easytarget/Aqua328-Hardware/Docs/AT328-aqua-controller.jpg

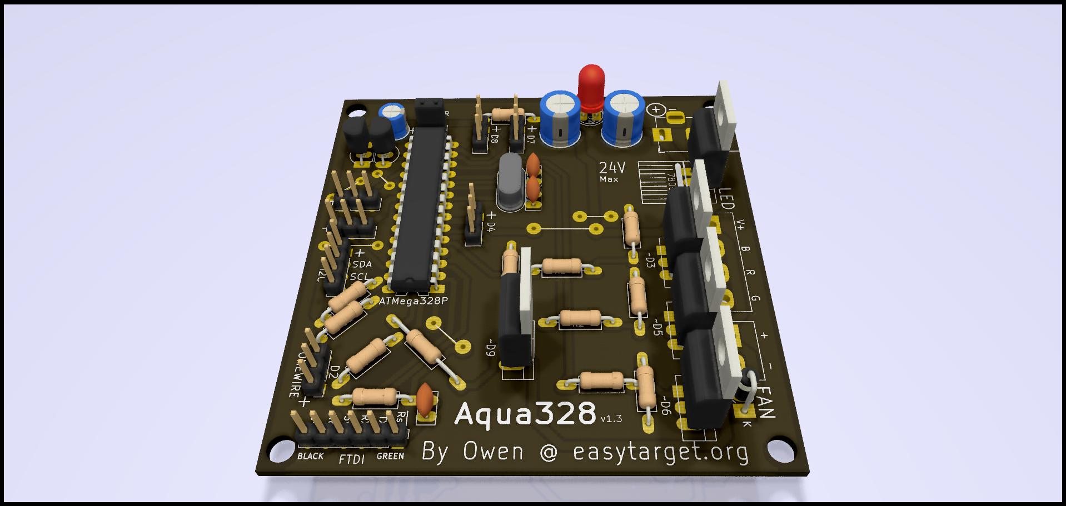
Docs/AT328-aqua-controller.jpg
