easytarget/Aqua328-Hardware/README.md

# Controller for a Public (attended) aquarium

See the Full project log on:
https://hackaday.io/project/167871-aqua328-flexible-aquarium-controller

Software is in:
https://github.com/easytarget/Aqua328-Software
