easytarget/Aqua328-Hardware/Case/aqua328-case.png

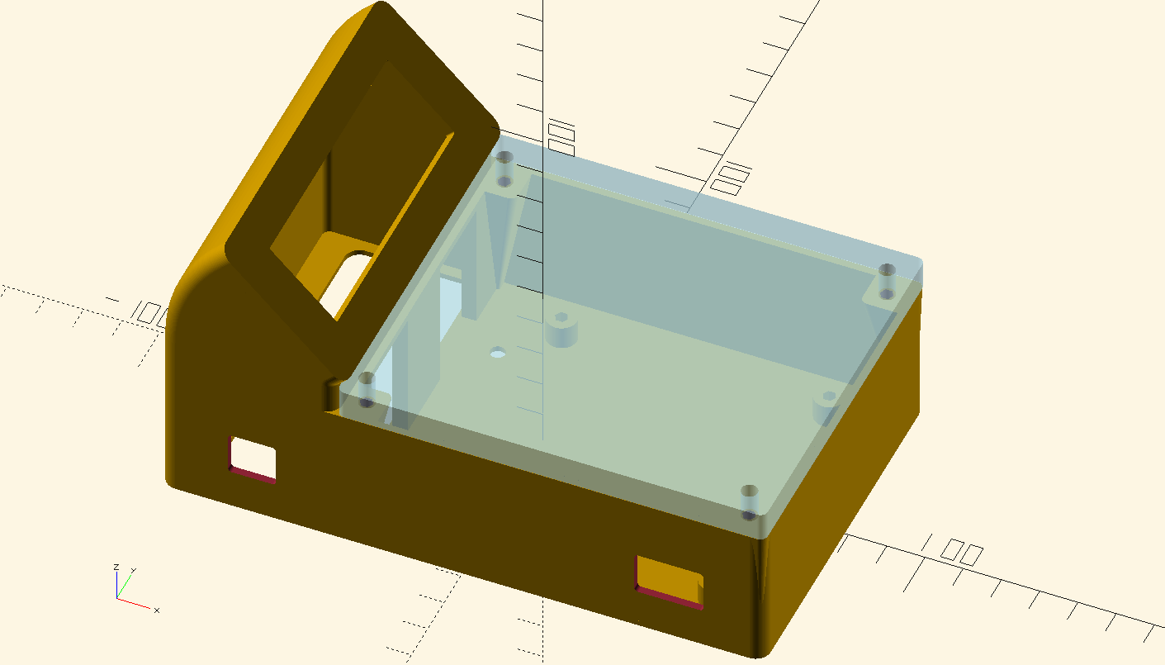
Case/aqua328-case.png
