easytarget/Aqua328-Hardware/Docs/Schematic.jpg

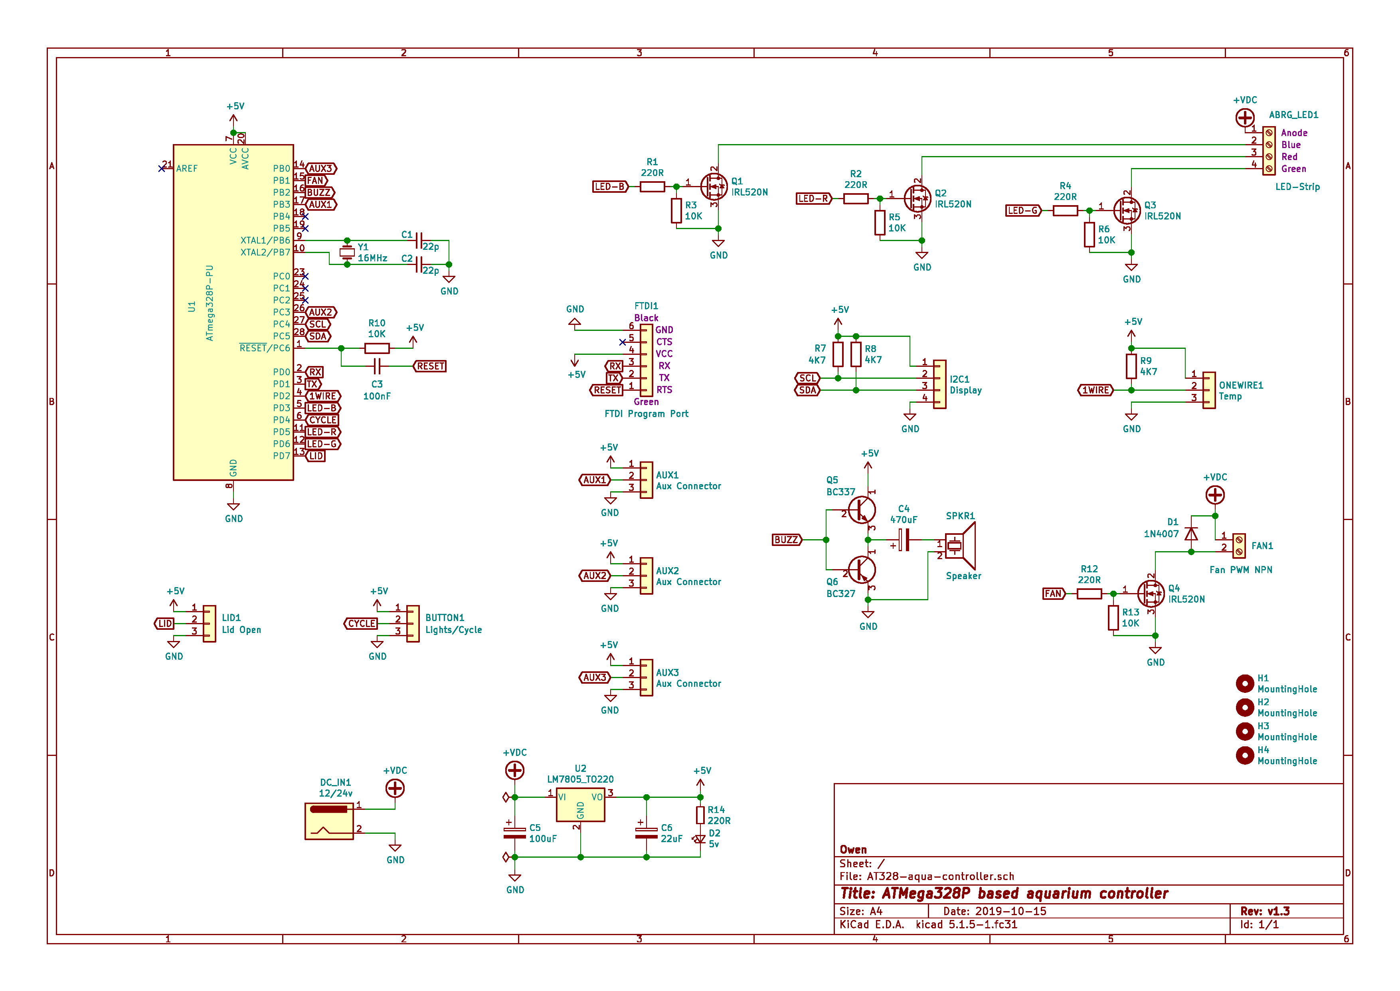
Docs/Schematic.jpg
