easytarget/Aqua328-Hardware/Case/aqua328-lid.stl

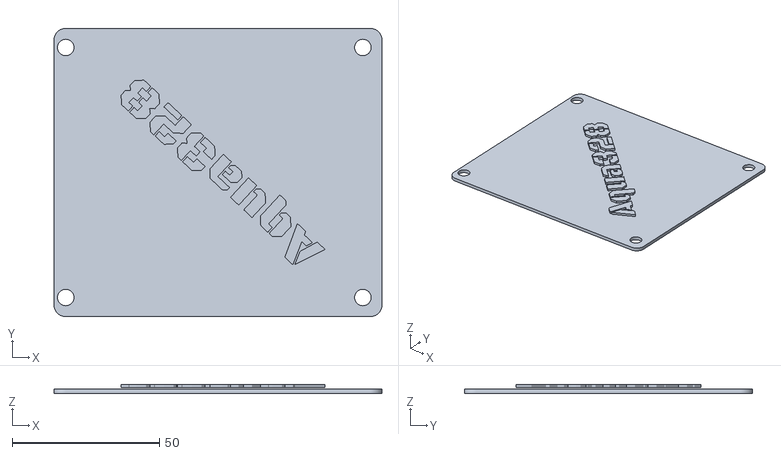
[picture p4: CAD file, 2020-04-11]
Case/aqua328-lid.stl
111.5 x 98.0 x 2.99
