easytarget/Aqua328-Hardware/Case/aqua328-case.stl

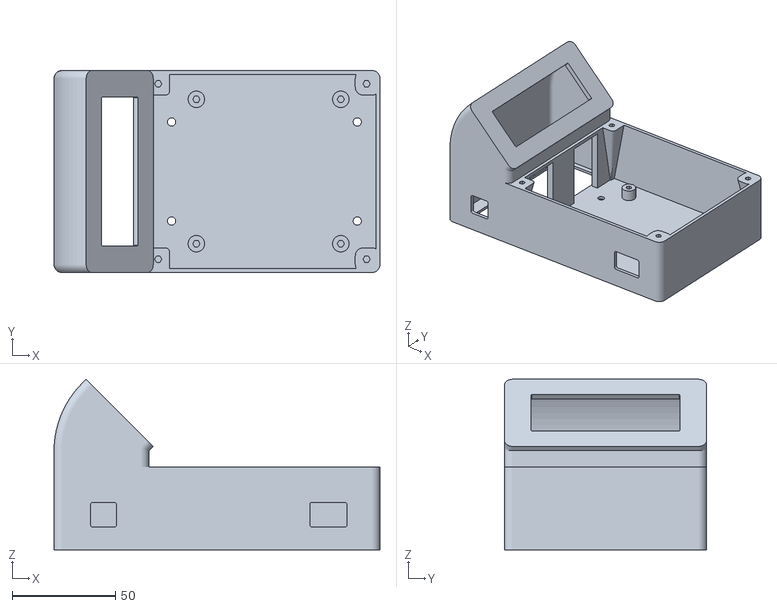
[picture p5: CAD file, 2020-02-27]
Case/aqua328-case.stl
158.0 x 98.0 x 82.6
