easytarget/Aqua328-Hardware/Case/1602lcd-spacer.stl

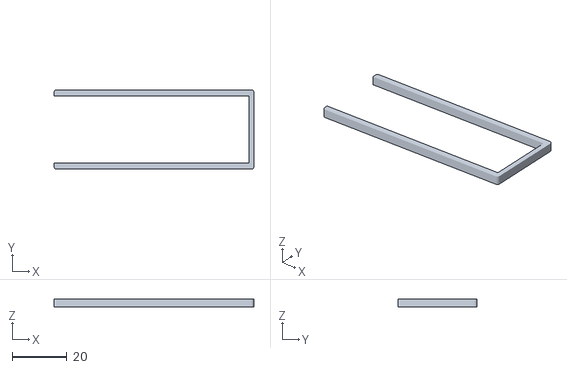
[picture p6: CAD file, 2020-02-23]
Case/1602lcd-spacer.stl
73.0 x 29.0 x 3.00
