easytarget/Aqua328-Hardware/Docs/AT328-aqua-controller.pdf

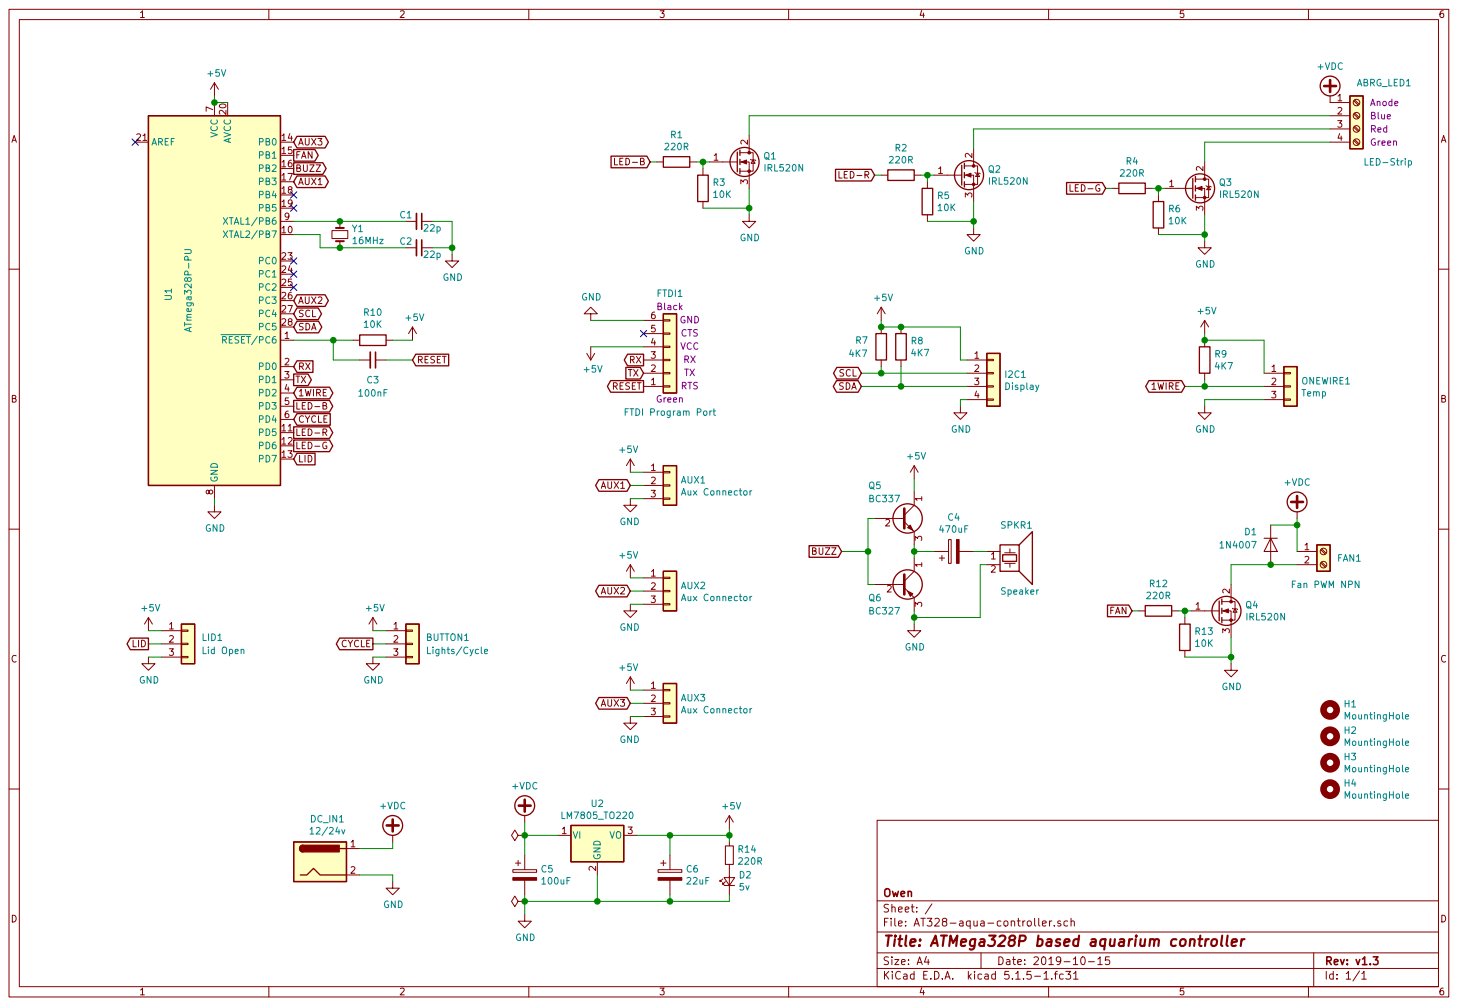
[picture p7: page 1]

LED-Strip Anode Blue Red Green GND

6FTDI1 FTDI Program Port Black GreenGND

Id: 1/1 Title: ATMega328P based aquarium controller
