easytarget/Aqua328-Hardware/AT328-aqua-controller.kicad_pcb

## KiCad design AT328-aqua-controller.kicad_pcb (2020-04-11)

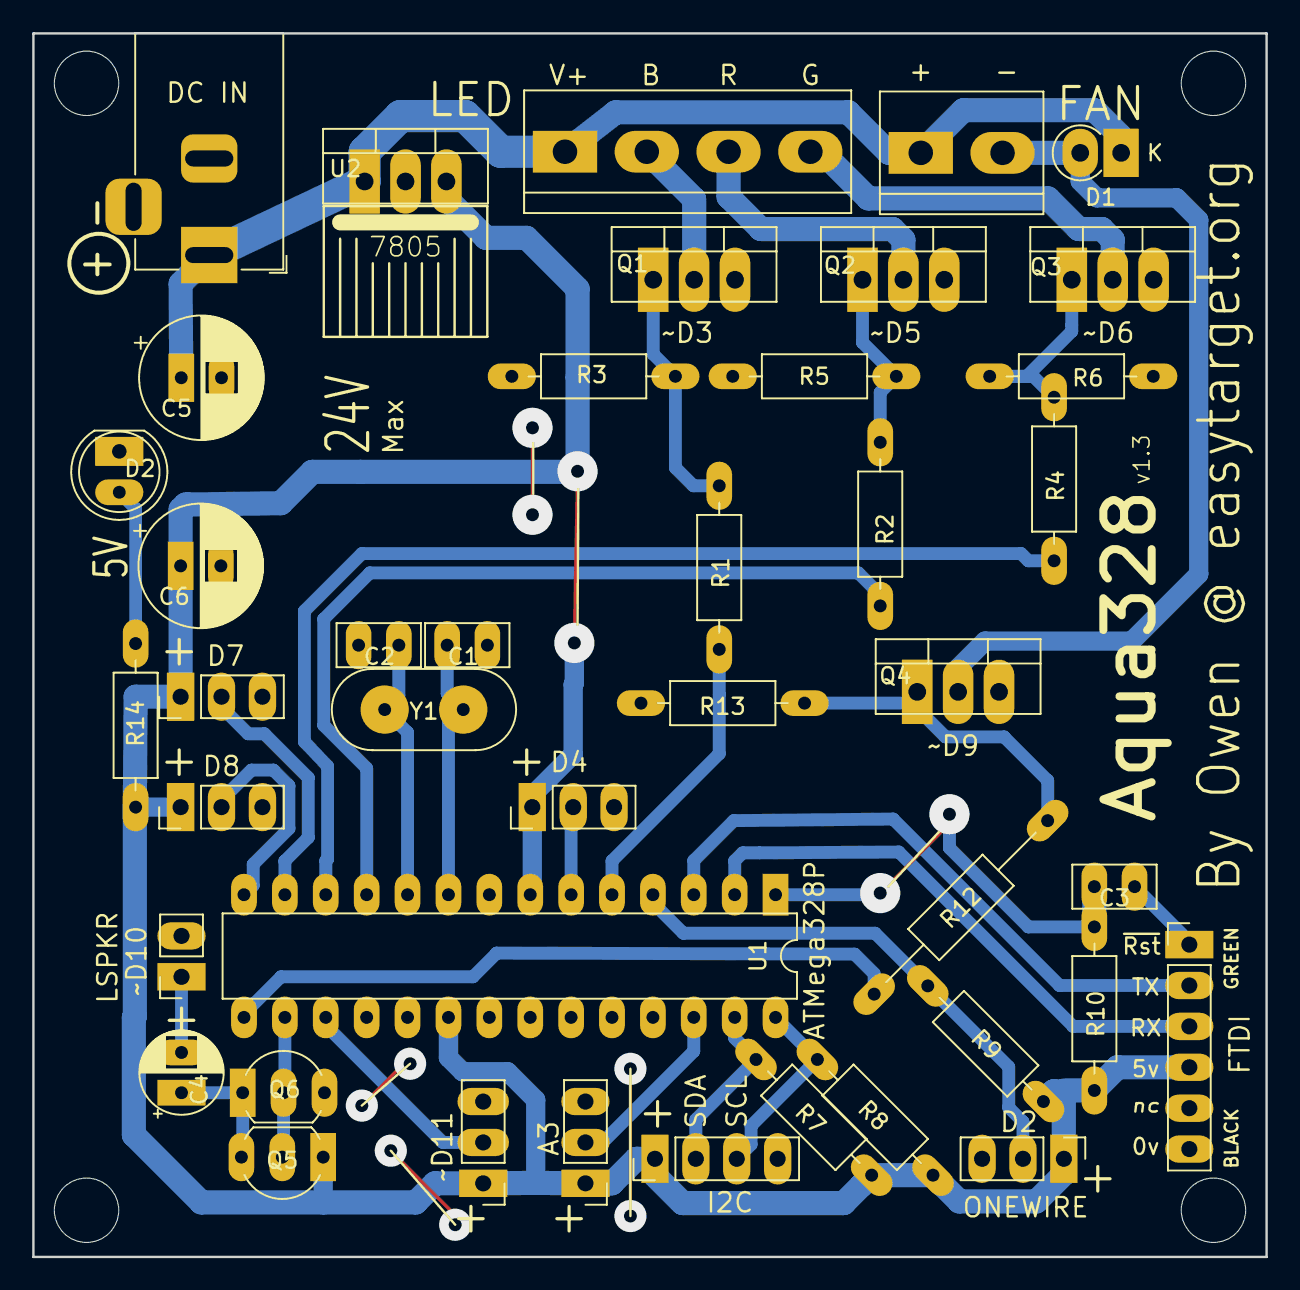
[picture p8: board AT328-aqua-controller.kicad_pcb from above]

Board: 2 copper layers, 76.6 x 76.0 mm, 46 parts (0 on the bottom side), 33 nets.

Parts:
ABRG_LED1: LED-Strip; TerminalBlock_bornier-4_P5.08mm
AUX1, AUX2, AUX3: Aux Connector; PinHeader_1x03_P2.54mm_Vertical
BUTTON1: Lights/Cycle; PinHeader_1x03_P2.54mm_Vertical
C1, C2: 22p; C_Disc_D5.0mm_W2.5mm_P2.50mm
C3: 100nF; C_Disc_D5.0mm_W2.5mm_P2.50mm
C4: 470uF; CP_Radial_D5.0mm_P2.50mm
C5: 100uF; CP_Radial_D7.5mm_P2.50mm
C6: 22uF; CP_Radial_D7.5mm_P2.50mm
D1: 1N4007; D_DO-41_SOD81_P2.54mm_Vertical_KathodeUp
D2: 5v; LED_D5.0mm
DC_IN1: 12/24v; BarrelJack_Horizontal
FAN1: Fan PWM NPN; TerminalBlock_bornier-2_P5.08mm
FTDI1: FTDI Program Port; PinHeader_1x06_P2.54mm_Vertical
H1, H2, H3, H4: MountingHole; MountingHole_4mm
I2C1: Display; PinHeader_1x04_P2.54mm_Vertical
LID1: Lid Open; PinHeader_1x03_P2.54mm_Vertical
ONEWIRE1: Temp; PinHeader_1x03_P2.54mm_Vertical
Q1, Q2, Q3, Q4: IRL520N; TO-220-3_Vertical
Q5: BC337; TO-92_Inline_Wide
Q6: BC327; TO-92_Inline_Wide
R1, R2, R4, R14: 220R; R_Axial_DIN0207_L6.3mm_D2.5mm_P10.16mm_Horizontal
R3, R5, R6, R10, R13: 10K; R_Axial_DIN0207_L6.3mm_D2.5mm_P10.16mm_Horizontal
R7, R8, R9: 4K7; R_Axial_DIN0207_L6.3mm_D2.5mm_P10.16mm_Horizontal
R12: 220R; R_Axial_DIN0207_L6.3mm_D2.5mm_P15.24mm_Horizontal
SPKR1: Speaker; PinSocket_1x02_P2.54mm_Vertical
U1: ATmega328P-PU; DIP-28_W7.62mm
U2: LM7805_TO220; TO-220-3_Vertical
Y1: 16MHz; Crystal_HC49-4H_Vertical

Connections:
1WIRE: ONEWIRE1.2, R9.2, U1.4
+5V: AUX1.1, AUX2.1, AUX3.1, BUTTON1.1, C6.1, FTDI1.4, I2C1.1, LID1.1, ONEWIRE1.1, Q5.1, R7.1, R8.1, R9.1, R10.2, R14.1, U1.7, U1.20, U2.3
+VDC: ABRG_LED1.1, C5.1, D1.1, DC_IN1.1, FAN1.1, U2.1
AUX1: AUX1.2, U1.17
AUX2: AUX2.2, U1.26
AUX3: AUX3.2, U1.14
BUZZ: Q5.2, Q6.2, U1.16
CYCLE: BUTTON1.2, U1.6
FAN: R12.2, U1.15
GND: AUX1.3, AUX2.3, AUX3.3, BUTTON1.3, C1.1, C2.1, C5.2, C6.2, D2.1, DC_IN1.2, FTDI1.6, I2C1.4, LID1.3, ONEWIRE1.3, Q1.3, Q2.3, Q3.3, Q4.3, Q6.3, R3.2, R5.2, R6.2, R13.2, SPKR1.2, U1.8, U1.22, U2.2
LED-B: R1.2, U1.5
LED-G: R4.2, U1.12
LED-R: R2.2, U1.11
LID: LID1.2, U1.13
unnamed: ABRG_LED1.2, Q1.2
unnamed: ABRG_LED1.3, Q2.2
unnamed: ABRG_LED1.4, Q3.2
unnamed: C1.2, U1.9, Y1.1
unnamed: C2.2, U1.10, Y1.2
unnamed: C3.2, R10.1, U1.1
unnamed: C4.1, Q5.3, Q6.1
unnamed: C4.2, SPKR1.1
unnamed: D1.2, FAN1.2, Q4.2
unnamed: D2.2, R14.2
unnamed: Q1.1, R1.1, R3.1
unnamed: Q2.1, R2.1, R5.1
unnamed: Q3.1, R4.1, R6.1
unnamed: Q4.1, R12.1, R13.1
RESET: C3.1, FTDI1.1
RX: FTDI1.3, U1.2
SCL: I2C1.2, R7.2, U1.27
SDA: I2C1.3, R8.2, U1.28
TX: FTDI1.2, U1.3
