easytarget/Aqua328-Hardware/(commit log)

2019-09-30 Initial; been in design for a while though.
    [AT328-aqua-controller.kicad_pcb, AT328-aqua-controller.sch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]
2019-09-30 More IO and better PCB silk
    [AT328-aqua-controller.kicad_pcb, AT328-aqua-controller.sch]
2019-10-04 More PCB work, adding power to all pins, more io and better silk
    [AT328-aqua-controller.kicad_pcb, AT328-aqua-controller.sch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]
2019-10-04 Bigger power terminals, all power wiring on one side, bigger power tracks
    [AT328-aqua-controller.kicad_pcb, AT328-aqua-controller.sch]
2019-10-15 Lots of minor tweaks to layout and silkscreen, possibly complete.
    [AT328-aqua-controller.kicad_pcb, AT328-aqua-controller.sch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]
2019-10-15 Add a version to silkscreen
    [AT328-aqua-controller.kicad_pcb]
2019-10-16 Minor silkscreen issues
    [AT328-aqua-controller.kicad_pcb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]
2019-10-27 PCB v1.3
    [AT328-aqua-controller.kicad_pcb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]
2020-02-23 Case Stuff
    [aqua328-case.scad, aqua328-case.stl]
2020-02-23 Adding a case and spacer for the LCD display
    [1602lcd-spacer.scad, 1602lcd-spacer.stl, aqua328-case.scad, aqua328-case.stl]
2020-02-27 Small redesign following prototype fitting. I'm fitting a speaker in place of the power jack, so I added a grill for that.
    [aqua328-case.scad, aqua328-case.stl]
2020-04-11 New speaker circuit, updated PCB to suit and slight case mods.
    [AT328-aqua-controller.kicad_pcb, AT328-aqua-controller.sch, aqua328-case.scad, aqua328-lid.stl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]
